ForestFrame/2023-nuedc-h-signal-separation-device/STM32/FFT/README.md

- 在main.h文件中添加#include "fft.h"头文件；
- 在fft.h和timer_dma_adc.h文件中分别设置fft点数和DMA一次传输（也即一次处理数据的个数）。
