ForestFrame/2023-nuedc-h-signal-separation-device/STM32/HAL_DELAY_US/README.md

- 在main.h文件中添加#include "hal_delay_us.h"头文件。
