ForestFrame/2023-nuedc-h-signal-separation-device/STM32/Inc/main.h

#define KEY0_Pin GPIO_PIN_4
#define KEY0_GPIO_Port GPIOE
#define KEY0_EXTI_IRQn EXTI4_IRQn
#define LED0_Pin GPIO_PIN_9
#define LED0_GPIO_Port GPIOF
#define LED1_Pin GPIO_PIN_10
#define LED1_GPIO_Port GPIOF
#define KEY_UP_Pin GPIO_PIN_0
#define KEY_UP_GPIO_Port GPIOA
#define KEY_UP_EXTI_IRQn EXTI0_IRQn
#define UART2_TX_Pin GPIO_PIN_2
#define UART2_TX_GPIO_Port GPIOA
#define ADC_IN_Pin GPIO_PIN_3
#define ADC_IN_GPIO_Port GPIOA
#define UART3_TX_Pin GPIO_PIN_10
#define UART3_TX_GPIO_Port GPIOB
#define UART3_RX_Pin GPIO_PIN_11
#define UART3_RX_GPIO_Port GPIOB
#define UART1_TX_Pin GPIO_PIN_9
#define UART1_TX_GPIO_Port GPIOA
#define UART1_RX_Pin GPIO_PIN_10
#define UART1_RX_GPIO_Port GPIOA
#define UART2_RX_Pin GPIO_PIN_6
#define UART2_RX_GPIO_Port GPIOD
