ForestFrame/2023-nuedc-h-signal-separation-device/(commit log)

2026-04-04 🎉 init(FPGA侧工程，STM32侧工程，doc文件夹): 项目组建完成
2026-04-06 📃 docs(README.md): 完成README文档的编写
