ForestFrame/2023-nuedc-h-signal-separation-device/(notices)

Notices in the files:
STM32/Src/sd_diskio.c:
Copyright (c) 2023 STMicroelectronics.
All rights reserved.
This software is licensed under terms that can be found in the LICENSE file
